mgerczuk/PCB-ESP32-power/OBD-II/C-OBD-II-16M.step

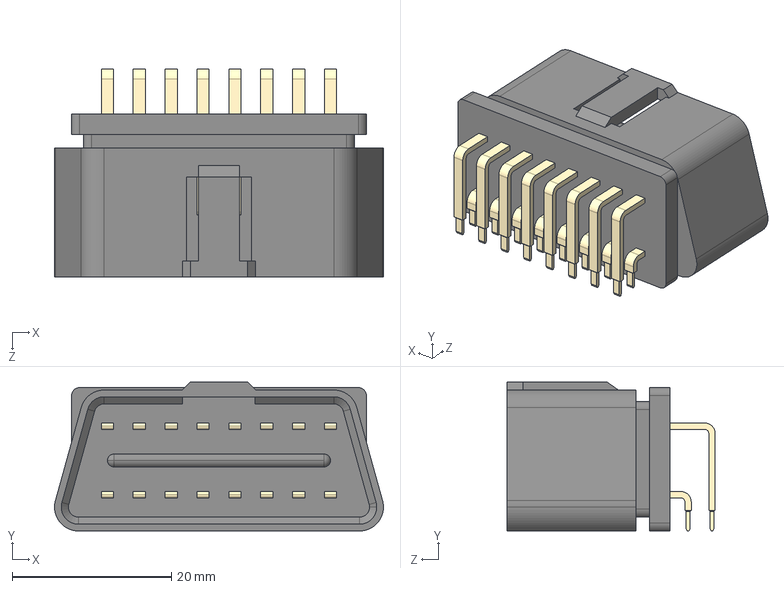
[picture p1: CAD file, 2021-07-23]
OBD-II/C-OBD-II-16M.step
41.3 x 18.7 x 26.2 mm
