mgerczuk/PCB-ESP32-power/(list of files, drawings)

Other design files:
pcb-esp32-power.dsn
