mgerczuk/PCB-ESP32-power/pcb-esp32-power.kicad_pcb

## KiCad design pcb-esp32-power.kicad_pcb (2021-12-10)

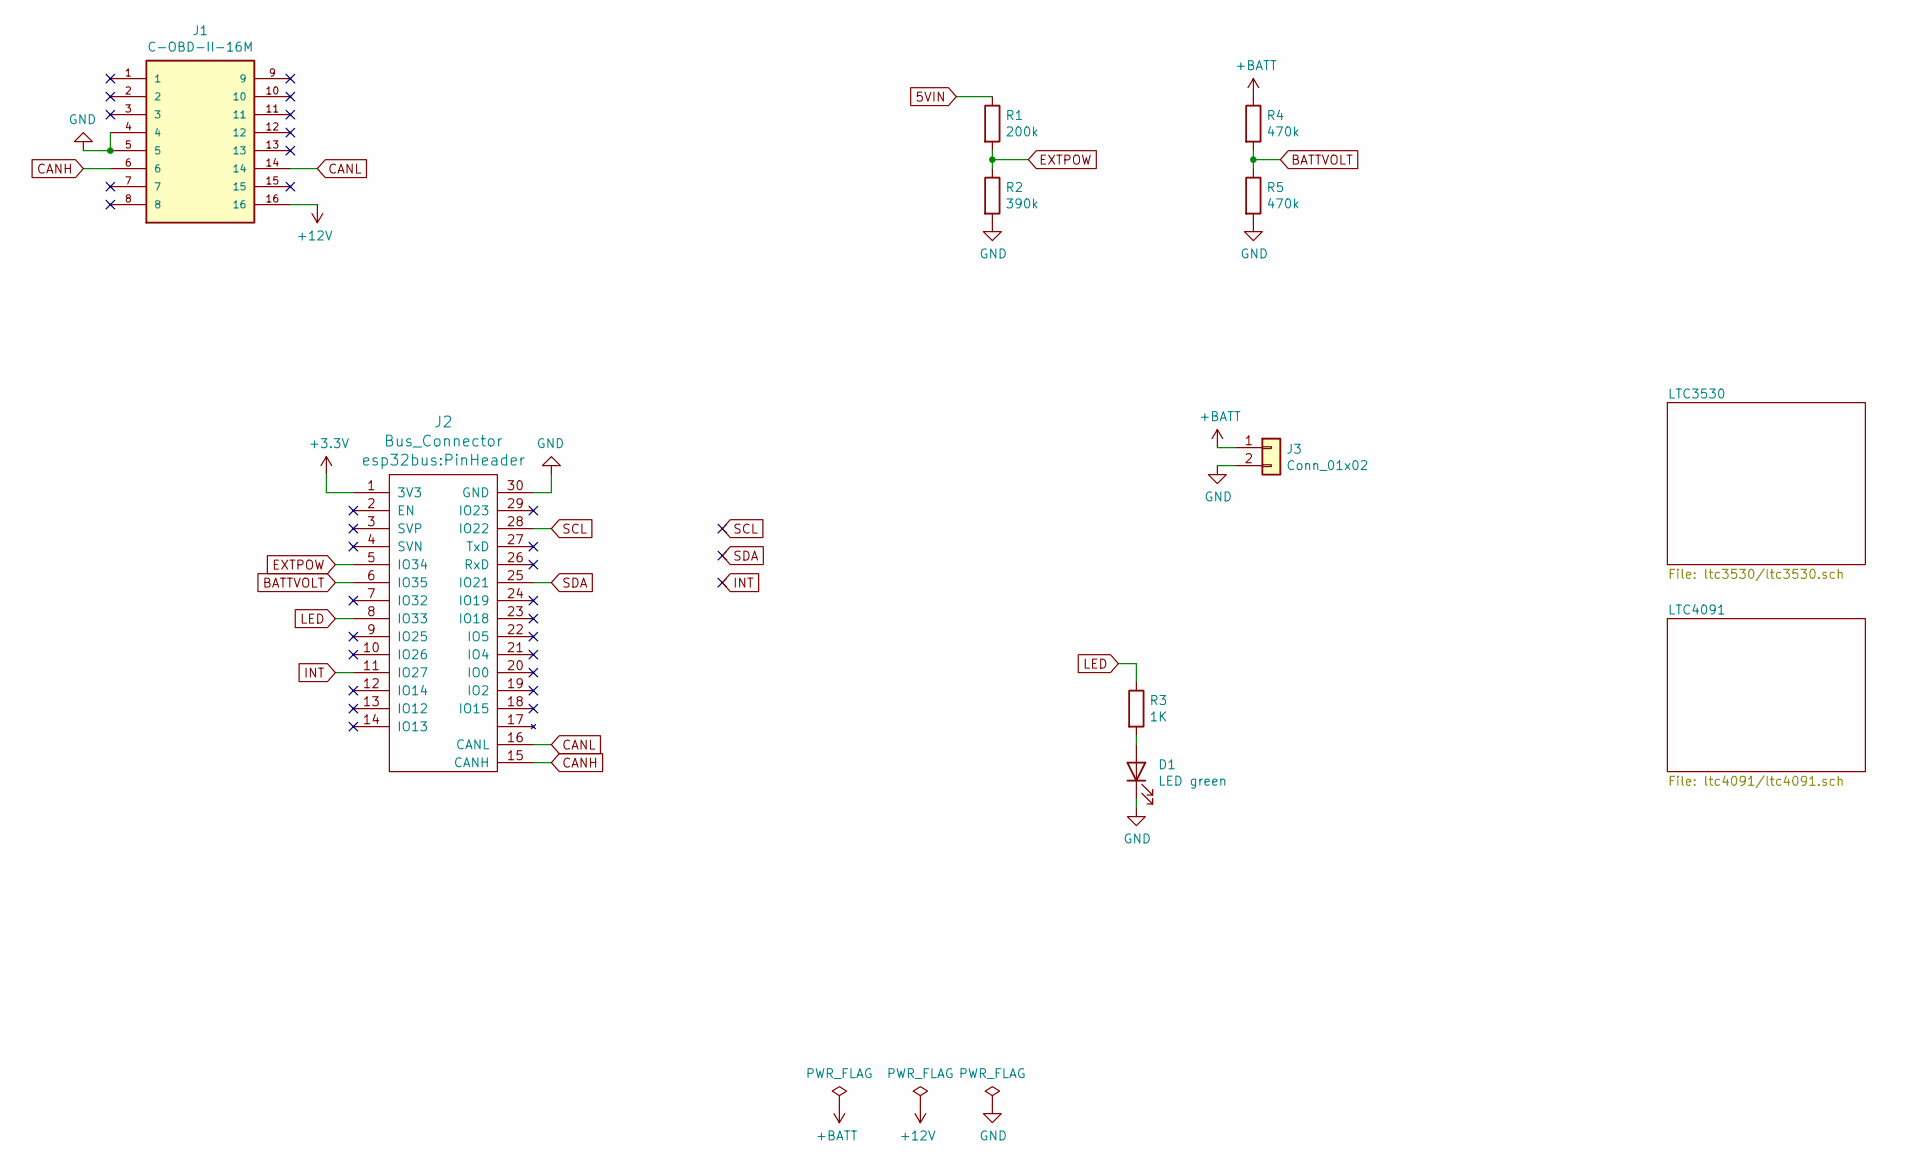
[picture p2: schematic pcb-esp32-power.sch]

Parts:
D1: LED green; LED_0805_2012Metric_Pad1.15x1.40mm_HandSolder
J1: C-OBD-II-16M; COMTECH_C-OBD-II-16M; PARTREV A
J2: Bus_Connector; PinHeader
J3: Conn_01x02; JST_XH_B2B-XH-A_1x02_P2.50mm_Vertical
R1: 200k; R_0603_1608Metric
R2: 390k; R_0603_1608Metric
R3: 1K; R_0603_1608Metric
R4, R5: 470k; R_0603_1608Metric

Connections:
5VIN: R1.1; also elsewhere on the board
+3V3: J2.1 (3V3); also elsewhere on the board
+12V: J1.16; also elsewhere on the board
+BATT: J3.1, R4.1; also elsewhere on the board
BATTVOLT: J2.6 (IO35), R4.2, R5.1
CANH: J1.6, J2.15 (CANH)
CANL: J1.14, J2.16 (CANL)
EXTPOW: J2.5 (IO34), R1.2, R2.1
GND: D1.1 (K), J1.4, J1.5, J2.30 (GND), J3.2, R2.2, R5.2; also elsewhere on the board
INT: J2.11 (IO27)
LED: J2.8 (IO33), R3.1
unnamed: D1.2 (A), R3.2
SCL: J2.28 (IO22)
SDA: J2.25 (IO21)

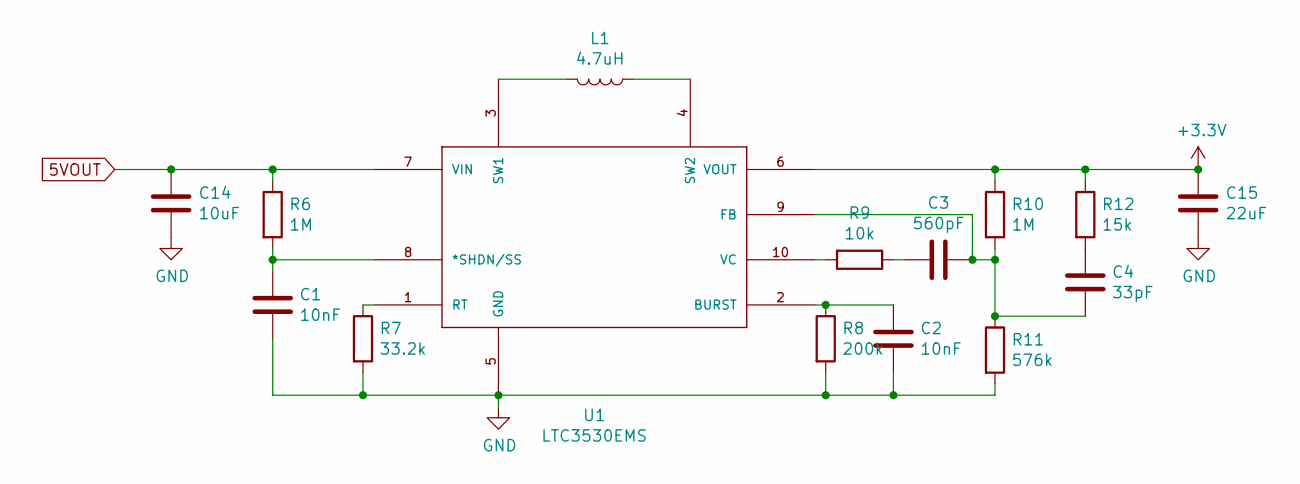
[picture p3: schematic ltc3530.sch]

Parts:
C1, C2: 10nF; C_0603_1608Metric
C3: 560pF; C_0603_1608Metric
C4: 33pF; C_0603_1608Metric
C14: 10uF; C_1206_3216Metric
C15: 22uF; C_1206_3216Metric
L1: 4.7uH; CKST0503
R6, R10: 1M; R_0603_1608Metric
R7: 33.2k; R_0603_1608Metric
R8: 200k; R_0603_1608Metric
R9: 10k; R_0603_1608Metric
R11: 576k; R_0603_1608Metric
R12: 15k; R_0603_1608Metric
U1: LTC3530EMS; MSOP-10_MS; MANUFACTURER_PART_NUMBER ltc3530ems

Connections:
5VOUT: C14.1, R6.1, U1.7 (VIN); also elsewhere on the board
+3V3: C15.1, R10.1, R12.1, U1.6 (VOUT); also elsewhere on the board
GND: C1.2, C2.2, C14.2, C15.2, R7.2, R8.2, R11.2, U1.5 (GND); also elsewhere on the board
unnamed: C1.1, R6.2, U1.8 (*SHDN/SS)
unnamed: C2.1, R8.1, U1.2 (BURST)
unnamed: C3.1, C4.2, R10.2, R11.1, U1.9 (FB)
unnamed: C3.2, R9.1
unnamed: C4.1, R12.2
unnamed: L1.1, U1.4 (SW2)
unnamed: L1.2, U1.3 (SW1)
unnamed: R7.1, U1.1 (RT)
unnamed: R9.2, U1.10 (VC)

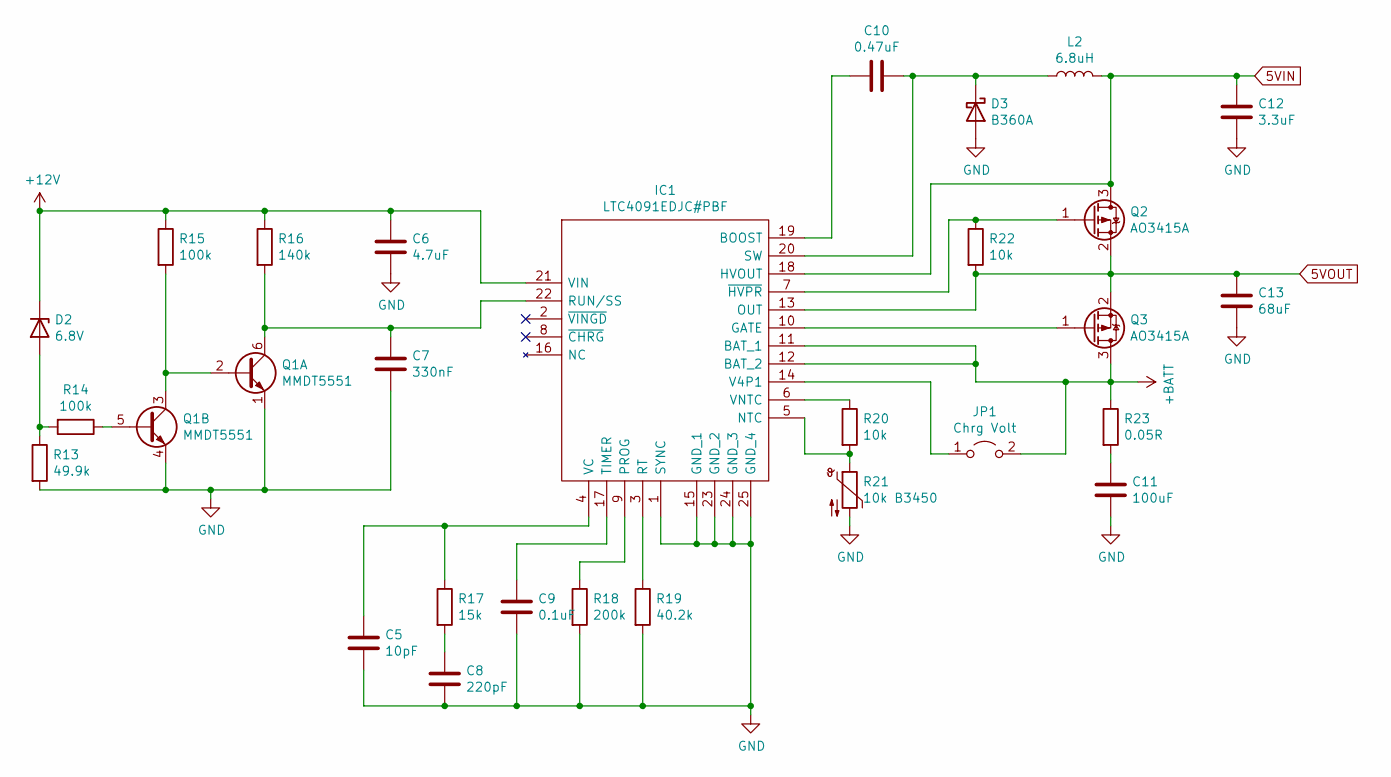
[picture p4: schematic ltc4091.sch]

Parts:
C5: 10pF; C_0603_1608Metric
C6: 4.7uF; C_1206_3216Metric; Mouser Part Number 81-GRM31CR71H475KA2L
C7: 330nF; C_0805_2012Metric; Mouser Part Number 81-GCM219R71H334KA5D
C8: 220pF; C_0603_1608Metric
C9: 0.1uF; C_0603_1608Metric
C10: 0.47uF; C_0603_1608Metric
C11: 100uF; C_1206_3216Metric
C12: 3.3uF; C_0603_1608Metric; Mouser Part Number 810-C1608X5R1C335KAC
C13: 68uF; C_1206_3216Metric; Mouser Part Number 810-C3216X5R1A686M1C
D2: 6.8V; D_SOD-123; Mouser Part Number 78-MMSZ5235B-G3-08
D3: B360A; D_SMA; Mouser Part Number 78-B360A-M3/61T
IC1: LTC4091EDJC#PBF; LTC4091EDJCPBF; Mouser Part Number 584-LTC4091EDJCPBF
JP1: Chrg Volt; SolderJumper-2_P1.3mm_Open_RoundedPad1.0x1.5mm
L2: 6.8uH; CKST0503
Q1: MMDT5551; SOT-363_SC-70-6; Mouser Part Number 621-MMDT5551-F
Q2, Q3: AO3415A; SOT-23
R13: 49.9k; R_0603_1608Metric; Mouser Part Number 71-CRCW0603-49.9K
R14, R15: 100k; R_0603_1608Metric
R16: 140k; R_0603_1608Metric; Mouser Part Number 603-RC0603FR-07140KL
R17: 15k; R_0603_1608Metric
R18: 200k; R_0603_1608Metric
R19: 40.2k; R_0603_1608Metric; Mouser Part Number 71-CRCW0603-40.2K
R20, R22: 10k; R_0603_1608Metric
R21: 10k B3450; R_0603_1608Metric
R23: 0.05R; R_0603_1608Metric; Mouser Part Number 603-PT0603FR-070R05L

Connections:
5VIN: C12.1, IC1.18 (HVOUT), L2.2, Q2.3 (D); also elsewhere on the board
5VOUT: C13.1, IC1.13 (OUT), Q2.2 (S), Q3.2 (S), R22.2; also elsewhere on the board
+12V: C6.1, D2.1 (K), IC1.21 (VIN), R15.1, R16.1; also elsewhere on the board
+BATT: IC1.11 (BAT_1), IC1.12 (BAT_2), JP1.2 (B), Q3.3 (D), R23.1; also elsewhere on the board
GND: C5.2, C6.2, C7.2, C8.2, C9.2, C11.2, C12.2, C13.2, D3.2 (A), IC1.1 (SYNC), IC1.15 (GND_1), IC1.23 (GND_2), IC1.24 (GND_3), IC1.25 (GND_4), Q1.1 (E1), Q1.4 (E2), R13.2, R18.2, R19.2, R21.2; also elsewhere on the board
unnamed: C5.1, IC1.4 (VC), R17.1
unnamed: C7.1, IC1.22 (RUN/SS), Q1.6 (C1), R16.2
unnamed: C8.1, R17.2
unnamed: C9.1, IC1.17 (TIMER)
unnamed: C10.1, D3.1 (K), IC1.20 (SW), L2.1
unnamed: C10.2, IC1.19 (BOOST)
unnamed: C11.1, R23.2
unnamed: D2.2 (A), R13.1, R14.2
unnamed: IC1.3 (RT), R19.1
unnamed: IC1.5 (NTC), R20.2, R21.1
unnamed: IC1.6 (VNTC), R20.1
unnamed: IC1.7 (~HVPR), Q2.1 (G), R22.1
unnamed: IC1.9 (PROG), R18.1
unnamed: IC1.10 (GATE), Q3.1 (G)
unnamed: IC1.14 (V4P1), JP1.1 (A)
unnamed: Q1.2 (B1), Q1.3 (C2), R15.2
unnamed: Q1.5 (B2), R14.1

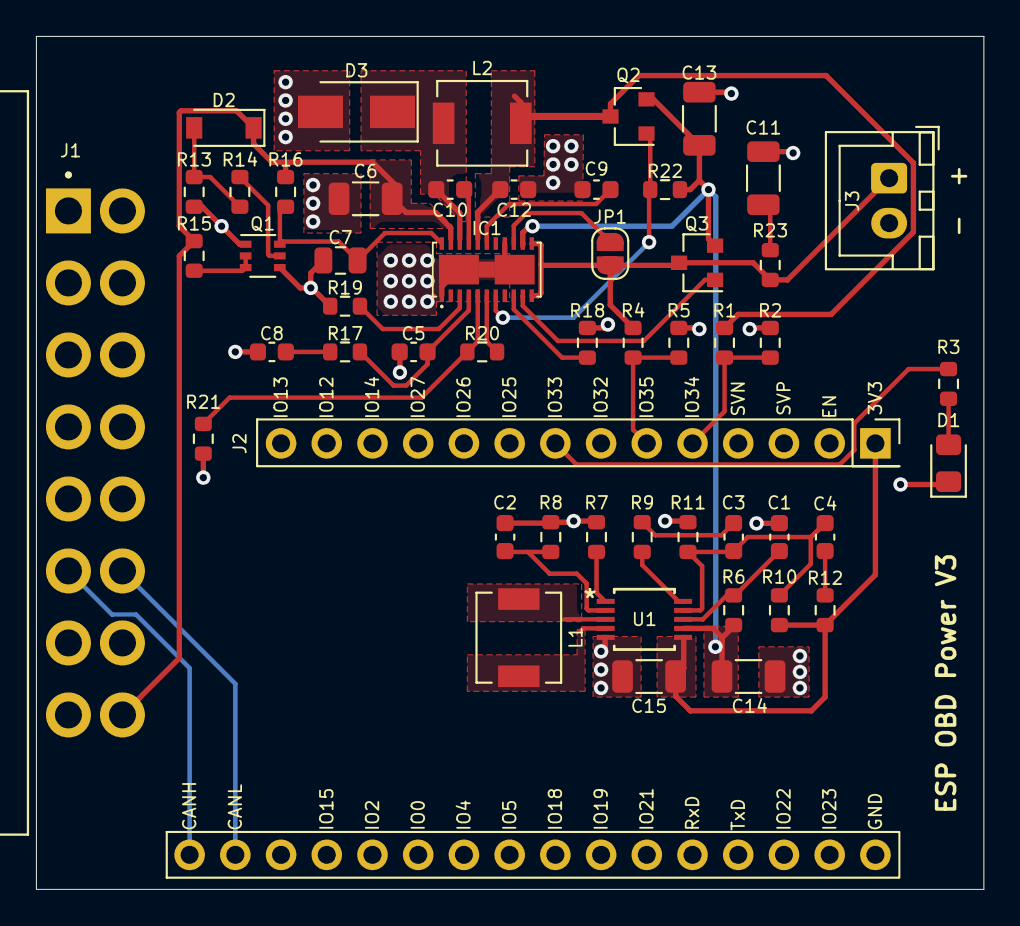
[picture p5: board pcb-esp32-power.kicad_pcb from above]

Board: 2 copper layers, 52.6 x 47.4 mm, 52 parts (0 on the bottom side), 38 nets.
