mgerczuk/PCB-ESP32-power/ip5108.kicad_pcb

## KiCad design ip5108.kicad_pcb (2021-07-19)

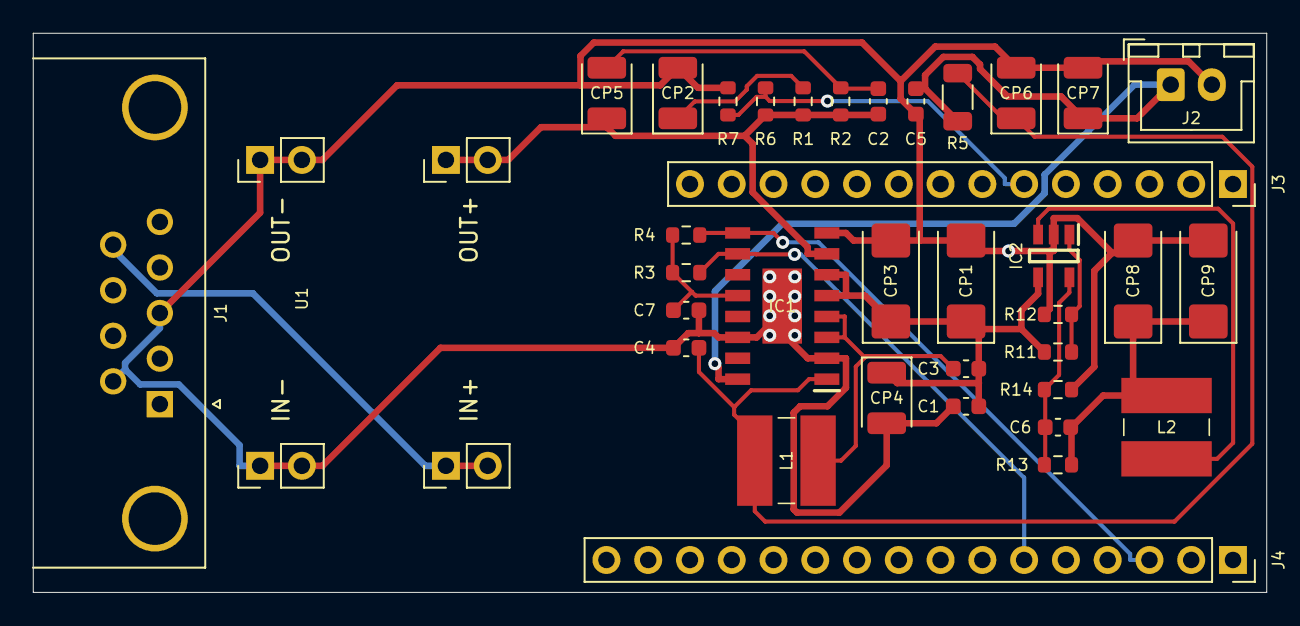
[picture p6: board ip5108.kicad_pcb from above]

Board: 2 copper layers, 75.0 x 34.0 mm, 36 parts (0 on the bottom side), 17 nets.

Parts:
C1, C2, C4, C5: 104; C_0603_1608Metric
C3: 4.7nF; C_0603_1608Metric
C6: 47pF; C_0603_1608Metric
C7: 2.2uF; C_0603_1608Metric
CP1, CP3, CP8, CP9: 22uF; CP_EIA-6032-28_Kemet-C
CP2, CP4, CP5, CP6, CP7: 10uF; CP_EIA-3528-21_Kemet-B
IC1: IP5108
IC2: SY8008B; SOT95P285X140-5N
J1: DB9_Female; DSUB-9_Female_Horizontal_P2.77x2.84mm_EdgePinOffset4.94mm_H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
J2: Conn_01x02; JST_XH_B2B-XH-A_1x02_P2.50mm_Vertical
J3: Conn_01x14; PinSocket_1x14_P2.54mm_Vertical
J4: Conn_01x16; PinSocket_1x16_P2.54mm_Vertical
L1: 1uH; CD54_Inductor
L2: 2.2uH; CD54_Inductor
R1: 2R; R_0603_1608Metric
R2: 1K; R_0603_1608Metric
R3, R4: 3.3k; R_0603_1608Metric
R5: 10mOhm; R_1206_3216Metric
R6, R7: R; R_0603_1608Metric
R11, R12: 100k; R_0603_1608Metric
R13: 453k 1%; R_0603_1608Metric
R14: 100k 1%; R_0603_1608Metric
U1: STEPDOWN12_5; StepDownBreakout

Connections:
5VIN: C2.1, CP5.1, IC1.7, R1.2, R2.1, R6.1, U1.5, U1.6
5VOUT: C1.1, C3.1, CP1.1, CP3.1, CP4.1, IC1.5, IC1.6, IC2.4, R11.1
+3V3: C6.1, CP8.1, CP9.1, L2.1, R13.1
+12V: J1.9, U1.1, U1.2
+BATT: C5.1, CP7.1, IC1.16, J2.1, R5.1
EXTPOW: J3.6, R6.2, R7.1
GND: C1.2, C4.2, C5.2, C7.2, CP1.2, CP2.2, CP3.2, CP4.2, CP6.2, CP7.2, CP8.2, CP9.2, IC1.2, IC1.8, IC1.14, IC1.17, IC2.2, J1.3, J1.6, J2.2, R7.2, R12.2, R14.2, U1.3, U1.4, U1.7, U1.8
unnamed: C2.2, CP5.2, R2.2
unnamed: C3.2, IC1.3, IC1.4, L1.2
unnamed: C4.1, CP6.1, IC1.1, L1.1, R5.2
unnamed: C6.2, IC2.5, R13.2, R14.1
unnamed: C7.1, IC1.12, R3.1, R4.1
unnamed: CP2.1, R1.1
unnamed: IC2.1, R11.2, R12.1
unnamed: IC2.3, L2.2
SCL: IC1.9, J4.3, R4.2
SDA: IC1.10, J4.6, R3.2
