mgerczuk/PCB-ESP32-power/(commit log)

2021-07-17 IP5108 in Unterschaltplan verschoben
    [5108.sch, ip5108.kicad_pcb, ip5108.sch]
2021-07-19 IP5108 in Unterverzeichnis verschoben
    [ip5108.dsn, ip5108.kicad_pcb, ip5108.sch]
2021-07-20 ESP32 Bus verwendet
    [pcb-esp32-power.dsn, pcb-esp32-power.kicad_pcb, pcb-esp32-power.sch]
2021-07-23 Breite Platine mit SUB D
    [pcb-esp32-power.dsn, pcb-esp32-power.kicad_pcb]
2021-07-23 Mit OBD II Stecker
    [C-OBD-II-16M.step, pcb-esp32-power.dsn, pcb-esp32-power.kicad_pcb, pcb-esp32-power.sch]
2021-07-24 Gerbers erstellt
    [pcb-esp32-power-B_Cu.gbr, pcb-esp32-power-B_Mask.gbr, pcb-esp32-power-B_Paste.gbr, pcb-esp32-power-B_SilkS.gbr, pcb-esp32-power-Edge_Cuts.gbr, pcb-esp32-power-F_Cu.gbr, pcb-esp32-power-F_Mask.gbr, pcb-esp32-power-F_Paste.gbr]
2021-07-26 Gerber mit korrekter Erweiterung
    [pcb-esp32-power-B_Cu.gbl, pcb-esp32-power-B_Mask.gbs, pcb-esp32-power-B_Paste.gbp, pcb-esp32-power-B_Paste.gbr, pcb-esp32-power-B_SilkS.gbo, pcb-esp32-power-B_SilkS.gbr, pcb-esp32-power-Edge_Cuts.gm1, pcb-esp32-power-F_Cu.gtl]
2021-08-06 Footprints für "Hand solder"
    [ip5108.sch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]
2021-08-27 Umstellung auf TP4054/SY8008/LTC3440
    [ip5108.sch, ltc3440.sch, pcb-esp32-power.sch, sy8008.sch, tp4054.sch]
2021-09-03 LTC3530 eingefügt
    [ltc3530.sch, pcb-esp32-power.sch, sy8008.sch, tp4054.sch]
2021-09-04 Mit SY8008
    [pcb-esp32-power.dsn, pcb-esp32-power.kicad_pcb, pcb-esp32-power.sch, sy8008.sch, tp4054.sch]
2021-09-04 Mit Sy8008 und LTC3530
    [ltc3530.sch, pcb-esp32-power.dsn, pcb-esp32-power.kicad_pcb, pcb-esp32-power.sch, sy8008.sch, tp4054.sch]
2021-09-10 LED zugefügt
    [pcb-esp32-power.kicad_pcb, pcb-esp32-power.sch, sy8008.sch]
2021-09-27 OBD Pin 4 & 5 an Masse
    [pcb-esp32-power.kicad_pcb, pcb-esp32-power.sch]
2021-10-29 Erste Version mit LTC4091
    [ltc3530.sch, ltc4091.sch, pcb-esp32-power.dsn, pcb-esp32-power.kicad_pcb, pcb-esp32-power.sch, sy8008.sch, tp4054.sch]
2021-10-29 Keine "Handsolder" Footprints mehr
    [ltc3530.sch, ltc4091.sch, pcb-esp32-power.dsn, pcb-esp32-power.kicad_pcb, pcb-esp32-power.sch]
2021-11-05 Footprint Änderungen Kondensatoren & Induktoren
    [ltc3530.sch, ltc4091.sch, pcb-esp32-power.kicad_pcb, pcb-esp32-power.sch]
2021-11-05 Nochmal überarbeitet
    [ltc4091.sch, pcb-esp32-power.dsn, pcb-esp32-power.kicad_pcb]
2021-11-07 Massefläche + Kleinigkeiten
    [pcb-esp32-power.kicad_pcb]
2021-11-09 Layout nochmal wg. kritischer Strompfade geändert
    [pcb-esp32-power.kicad_pcb]
2021-11-09 Gerber erstellt
    [pcb-esp32-power-B_Cu.gbl, pcb-esp32-power-B_Mask.gbs, pcb-esp32-power-B_Paste.gbp, pcb-esp32-power-B_SilkS.gbo, pcb-esp32-power-Edge_Cuts.gm1, pcb-esp32-power-F_Cu.gtl, pcb-esp32-power-F_Mask.gts, pcb-esp32-power-F_Paste.gtp]
2021-12-10 Pads von LTC3530 verkleinert
    [pcb-esp32-power.kicad_pcb]
